drogg1/icebreaker/hardware/bitsy-v1.1b/icebreaker-bitsy.kicad_pcb

## KiCad design hardware/bitsy-v1.1b/icebreaker-bitsy.kicad_pcb (2021-01-15)

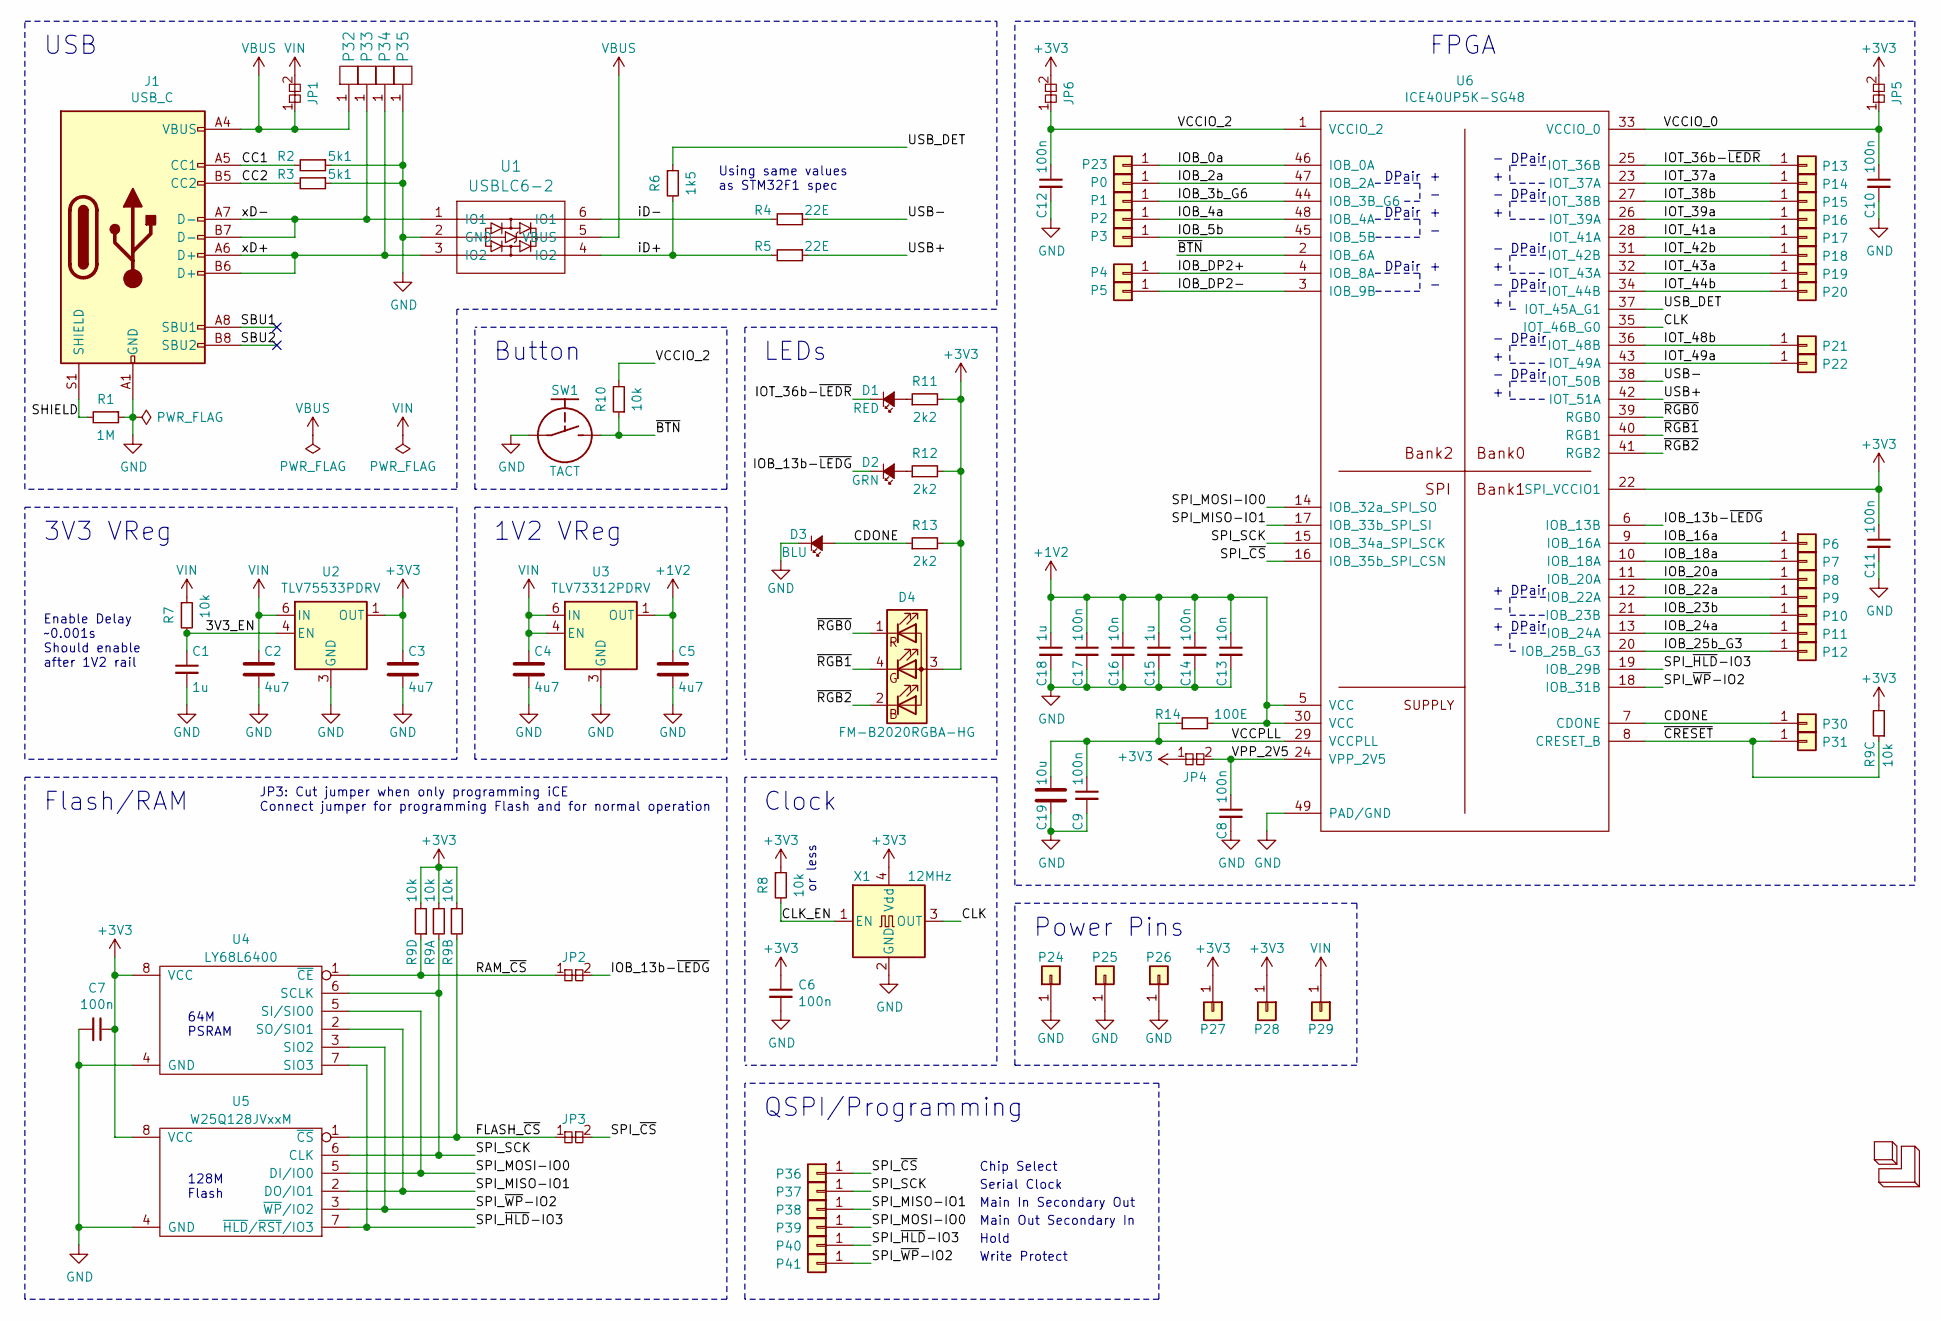
[picture p1: schematic icebreaker-bitsy.kicad_sch, iCEBreaker Bitsy]

Parts:
C1, C15, C18: 1u; C_0402
C2, C3, C4, C5: 4u7; C_0603
C6, C7, C8, C9, C10, C11, C12, C14, C17: 100n; C_0402
C13, C16: 10n; C_0402
C19: 10u; C_0603
D1: RED; D_0603
D2: GRN; D_0603
D3: BLU; D_0603
D4: FM-B2020RGBA-HG; LED_TRI_2020
J1: USB_C; USB_C_Receptacle_HRO_TYPE-C-31-M-12
JP1: Jumper; J_NC_0603_40
JP2, JP3: Jumper; J_NC_0402_15
JP4: Jumper; J_NC_0402_30
JP5, JP6: Jumper; J_NC_0603_30
LOGO1: 1BitSquared; 1b2_Logo_SilkS_6.5mm
P0: 0; Pin_Header_Straight_Round_1x01_Castellated
P1: 1; Pin_Header_Straight_Round_1x01_Castellated
P2: 2; Pin_Header_Straight_Round_1x01_Castellated
P3: 3; Pin_Header_Straight_Round_1x01_Castellated
P4: 4; Pin_Header_Straight_Round_1x01_Castellated
P5: 5; Pin_Header_Straight_Round_1x01_Castellated
P6: 6; Pin_Header_Straight_Round_1x01_Castellated
P7: 7; Pin_Header_Straight_Round_1x01_Castellated
P8: 8; Pin_Header_Straight_Round_1x01_Castellated
P9: 9; Pin_Header_Straight_Round_1x01_Castellated
P10: 10; Pin_Header_Straight_Round_1x01_Castellated
P11: 11; Pin_Header_Straight_Round_1x01_Castellated
P12: 12; Pin_Header_Straight_Round_1x01_Castellated
P13: 13; Pin_Header_Straight_Round_1x01_Castellated
P14: 14; Pin_Header_Straight_Round_1x01_Castellated
P15: 15; Pin_Header_Straight_Round_1x01_Castellated
P16: 16; Pin_Header_Straight_Round_1x01_Castellated
P17: 17; Pin_Header_Straight_Round_1x01_Castellated
P18: 18; Pin_Header_Straight_Round_1x01_Castellated
P19: 19; Pin_Header_Straight_Round_1x01_Castellated
P20: 20; Pin_Header_Straight_Round_1x01_Castellated
P21: 21; Pin_Header_Straight_Round_1x01_Castellated
P22: 22; Pin_Header_Straight_Round_1x01_Castellated
P23: 23; Pin_Header_Straight_Round_1x01_Castellated
P24, P25, P26: GND; Pin_Header_Straight_Round_1x01_Castellated
P27, P28: 3V3; Pin_Header_Straight_Round_1x01_Castellated
P29: VIN; Pin_Header_Straight_Round_1x01_Castellated
P30: CDONE; Pin_Header_Straight_Round_1x01_Castellated
P31: CRESET; Pin_Header_Straight_Round_1x01_Castellated
P32, P33, P34, P35: UP; PAD_SMD_1x2.65_ROUNDED
P36: CS; Pin_Header_Straight_Round_1x01
P37: SCK; Pin_Header_Straight_Round_1x01
P38: MISO; Pin_Header_Straight_Round_1x01
P39: MOSI; Pin_Header_Straight_Round_1x01
P40: IO3; PAD_SMD_R_1x1
P41: IO2; PAD_SMD_R_1x1
R1: 1M; R_0402
R2, R3: 5k1; R_0402
R4, R5: 22E; R_0402
R6: 1k5; R_0402
R7, R8, R10: 10k; R_0402
R9: 10k; R_Array_Convex_4x0402
R11, R12, R13: 2k2; R_0402
R14: 100E; R_0402
SW1: TACT; SW_SPST_3x4x2.5
U1: USBLC6-2; SOT-666
U2: TLV75533PDRV; WSON-6-1EP_2x2mm_P0.65mm_EP1x1.6mm
U3: TLV73312PDRV; WSON-6-1EP_2x2mm_P0.65mm_EP1x1.6mm
U4: LY68L6400; SOIC-8_3.9x4.9mm_P1.27mm
U5: W25Q128JVxxM; WSON-8-1EP_6x5mm_P1.27mm_EP3.4x4.3mm
U6: ICE40UP5K-SG48; QFN-48-1EP_7x7mm_Pitch0.5mm
X1: 12MHz; Oscillator_SMD_SCTF_S2DXX-4Pin_2.5x2.0mm

Connections:
+1V2: C5.1, C13.1, C14.1, C15.1, C16.1, C17.1, C18.1, R14.2, U3.1 (OUT), U6.5 (VCC), U6.30 (VCC)
+3V3: C3.1, C6.1, C7.1, C11.1, D4.3 (A), JP4.1, JP5.2, JP6.2, P27.1, P28.1, R8.1, R9.1, R9.3, R9.6, R9.8, R11.2, R12.2, R13.2, U2.1 (OUT), U4.8 (VCC), U5.8 (VCC), U6.22 (SPI_VCCIO1), X1.4 (Vdd)
/3V3_EN: C1.1, R7.2, U2.4 (EN)
/CC1: J1.A5 (CC1), R2.2
/CC2: J1.B5 (CC2), R3.2
/CDONE: D3.A, P30.1, R13.1, U6.7 (CDONE)
/CLK: U6.35 (IOT_46B_G0), X1.3 (OUT)
/CLK_EN: R8.2, X1.1 (EN)
/FLASH_~CS: JP3.1, R9.4, U5.1 (~CS)
/IOB_0a: P23.1, U6.46 (IOB_0A)
/IOB_2a: P0.1, U6.47 (IOB_2A)
/IOB_3b_G6: P1.1, U6.44 (IOB_3B_G6)
/IOB_4a: P2.1, U6.48 (IOB_4A)
/IOB_5b: P3.1, U6.45 (IOB_5B)
/IOB_13b-~LEDG: D2.C, JP2.2, U6.6 (IOB_13B)
/IOB_16a: P6.1, U6.9 (IOB_16A)
/IOB_18a: P7.1, U6.10 (IOB_18A)
/IOB_20a: P8.1, U6.11 (IOB_20A)
/IOB_22a: P9.1, U6.12 (IOB_22A)
/IOB_23b: P10.1, U6.21 (IOB_23B)
/IOB_24a: P11.1, U6.13 (IOB_24A)
/IOB_25b_G3: P12.1, U6.20 (IOB_25B_G3)
/IOB_DP2+: P4.1, U6.4 (IOB_8A)
/IOB_DP2-: P5.1, U6.3 (IOB_9B)
/IOT_36b-~LEDR: D1.C, P13.1, U6.25 (IOT_36B)
/IOT_37a: P14.1, U6.23 (IOT_37A)
/IOT_38b: P15.1, U6.27 (IOT_38B)
/IOT_39a: P16.1, U6.26 (IOT_39A)
/IOT_41a: P17.1, U6.28 (IOT_41A)
/IOT_42b: P18.1, U6.31 (IOT_42B)
/IOT_43a: P19.1, U6.32 (IOT_43A)
/IOT_44b: P20.1, U6.34 (IOT_44B)
/IOT_48b: P21.1, U6.36 (IOT_48B)
/IOT_49a: P22.1, U6.43 (IOT_49A)
/RAM_~CS: JP2.1, R9.7, U4.1 (~CE)
/SBU1: J1.A8 (SBU1)
/SBU2: J1.B8 (SBU2)
/SHIELD: J1.S1 (SHIELD), R1.2
/SPI_MISO-IO1: P38.1, U4.2 (SO/SIO1), U5.2 (DO/IO1), U6.17 (IOB_33b_SPI_SI)
/SPI_MOSI-IO0: P39.1, U4.5 (SI/SIO0), U5.5 (DI/IO0), U6.14 (IOB_32a_SPI_SO)
/SPI_SCK: P37.1, R9.2, U4.6 (SCLK), U5.6 (CLK), U6.15 (IOB_34a_SPI_SCK)
/SPI_~CS: JP3.2, P36.1, U6.16 (IOB_35b_SPI_CSN)
/SPI_~HLD~-IO3: P40.1, U4.7 (SIO3), U5.7 (~HLD~/~RST~/IO3), U6.19 (IOB_29B)
/SPI_~WP~-IO2: P41.1, U4.3 (SIO2), U5.3 (~WP~/IO2), U6.18 (IOB_31B)
/USB+: R5.1, U6.42 (IOT_51A)
/USB-: R4.1, U6.38 (IOT_50B)
/USB_DET: R6.1, U6.37 (IOT_45A_G1)
/VCCIO_0: C10.1, JP5.1, U6.33 (VCCIO_0)
/VCCIO_2: C12.1, JP6.1, R10.2, U6.1 (VCCIO_2)
/VCCPLL: C9.1, C19.1, R14.1, U6.29 (VCCPLL)
/VPP_2V5: C8.1, JP4.2, U6.24 (VPP_2V5)
/iD+: R5.2, R6.2, U1.4 (IO2)
/iD-: R4.2, U1.6 (IO1)
/xD+: J1.A6 (D+), J1.B6 (D+), P34.1 (PAD), U1.3 (IO2)
/xD-: J1.A7 (D-), J1.B7 (D-), P33.1 (PAD), U1.1 (IO1)
/~BTN: R10.1, SW1.2, U6.2 (IOB_6A)
/~CRESET: P31.1, R9.5, U6.8 (CRESET_B)
/~RGB0: D4.1 (RK), U6.39 (RGB0)
/~RGB1: D4.4 (GK), U6.40 (RGB1)
/~RGB2: D4.2 (BK), U6.41 (RGB2)
GND: C1.2, C2.2, C3.2, C4.2, C5.2, C6.2, C7.2, C8.2, C9.2, C10.2, C11.2, C12.2, C13.2, C14.2, C15.2, C16.2, C17.2, C18.2, C19.2, D3.C, J1.A1 (GND), J1.A12 (GND), J1.B1 (GND), J1.B12 (GND), P24.1, P25.1, P26.1, P35.1 (PAD), R1.1, R2.1, R3.1, SW1.1, U1.2 (GND), U2.3 (GND), U2.7 (GND), U3.3 (GND), U3.7 (GND), U4.4 (GND), U5.4 (GND), U6.49 (PAD/GND), X1.2 (GND)
unnamed: D1.A, R11.1
unnamed: D2.A, R12.1
VBUS: J1.A4 (VBUS), J1.A9 (VBUS), J1.B4 (VBUS), J1.B9 (VBUS), JP1.1, P32.1 (PAD), U1.5 (VBUS)
VIN: C2.1, C4.1, JP1.2, P29.1, R7.1, U2.6 (IN), U3.4 (EN), U3.6 (IN)

Notes on the sheet:
USB
3V3 VReg
Enable Delay ~~0.001s Should enable after 1V2 rail
Flash/RAM
64M PSRAM
128M Flash
JP3: Cut jumper when only programming iCE Connect jumper for programming Flash and for normal operation
Button
1V2 VReg
Using same values as STM32F1 spec
LEDs
Clock
QSPI/Programming
or less
Chip Select
Serial Clock
Main In Secondary Out
Main Out Secondary In
Hold
Write Protect
Power Pins
DPair
FPGA

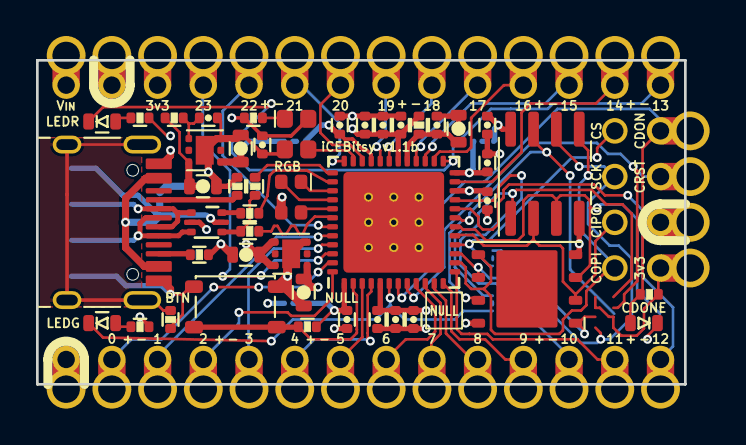
[picture p2: board icebreaker-bitsy.kicad_pcb from above]

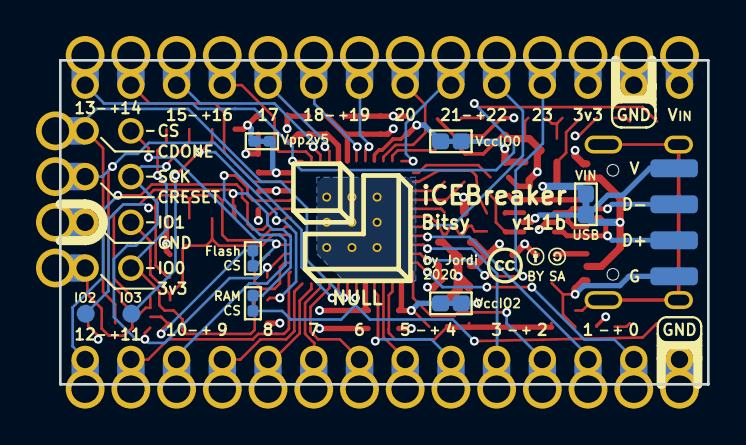
[picture p3: board icebreaker-bitsy.kicad_pcb from below]

Board: 4 copper layers, 36.0 x 18.0 mm, 94 parts (13 on the bottom side), 63 nets.
