drogg1/icebreaker/(commit log)

2021-01-15 Rerouted USB Diff Pair and added BCop GND Pour
    [icebreaker-bitsy.kicad_pcb, icebreaker-bitsy.kicad_sch]
2021-01-15 Exploring DiffPair Routing
    [icebreaker-bitsy.kicad_pcb, icebreaker-bitsy.kicad_sch]
