drogg1/icebreaker/(notices)

Notices in the files:
hardware/bitsy-v1.1b/icebreaker-bitsy.kicad_sch:
© 2018-2020 1BitSquared
© 2018-2020 Piotr Esden-Tempski
© 2020 Jordi Pakey-Rodriguez
License: CC BY-SA 4.0
